wereallgeek/F4992-ESP32S3/images/compuselectorSchematics.png

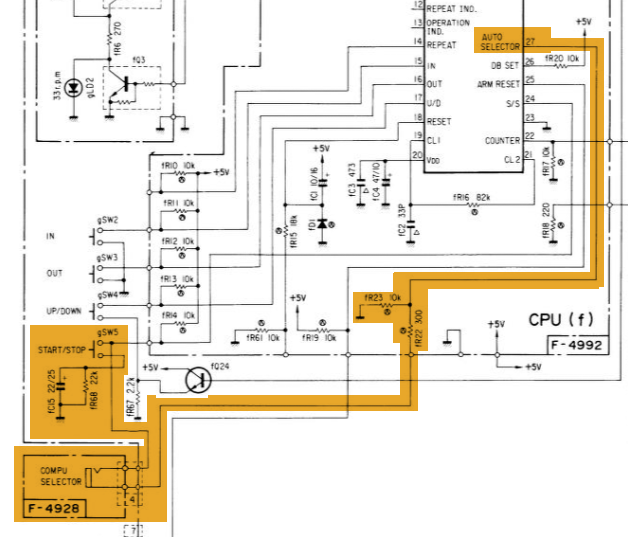
images/compuselectorSchematics.png
