wereallgeek/F4992-ESP32S3/images/zeroize.png

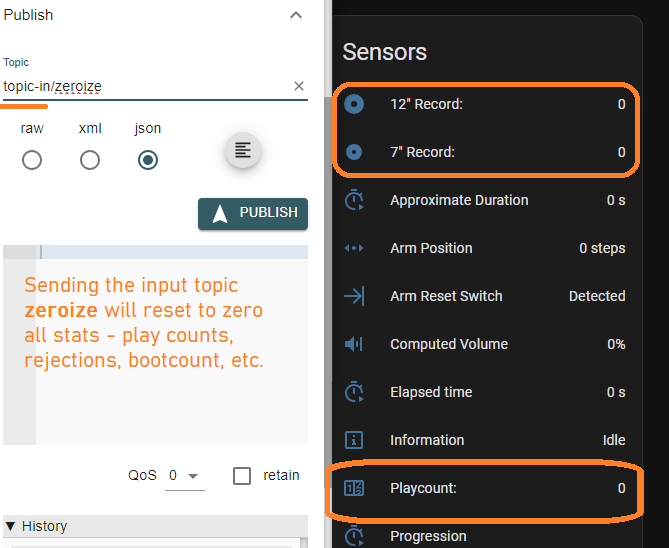
images/zeroize.png
