wereallgeek/F4992-ESP32S3/F4992-ESP32/simpleOTA.ino

//============================================================
// Simple OTA for ESP32
// 
// Opens a webserver onto which a .bin file can be uploaded
//  to the ESP for update. 
//
// Uses update.h
//
// let's build geeky things.
//                   We're all geeks
//
//============================================================
#include <WiFi.h>
#include <ESPAsyncWebServer.h>
#include <Update.h>

#define OTAPORT 4992
#define EMERPORT 80


const char* otalogo = "<img src='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' style='width:100px; margin-bottom:20px;'>";
const char* otastyle =   "<style>"
  "body{background-color:#121212;color:#ffffff;font-family:sans-serif;display:flex;flex-direction:column;justify-content:center;align-items:center;height:100vh;margin:0;}"
  ".loader{border:4px solid #333;border-top:4px solid #4caf50;border-radius:50%;width:30px;height:30px;animation:spin 1s linear infinite;margin:20px auto;}"
  "@keyframes spin{0%{transform:rotate(0deg);}100%{transform:rotate(360deg);}}"
  "</style>";

//OTA==================================================================
AsyncWebServer updateserver(OTAPORT);
AsyncWebServer emergencyserver(EMERPORT);

String updateIndex = String(otastyle) + "<form method='POST' action='/doupdate' enctype='multipart/form-data' style='text-align:center;' onsubmit='showWait()'>"
                   + String(otalogo)  + "<h5>F4992-ESP32S3 turntable controller Firmware update</h5>"
  "<p style='font-size:0.8em;color:#aaaaaa;'>current fw version = " + String(firmwareVersion()) + "</p>"
  "<div id='fcontent'>"
    "<input type='file' name='update' accept='.bin' style='margin-bottom:20px;' required>"
    "<br>"
    "<input type='submit' value='UPDATE' style='padding:10px 20px;cursor:pointer;'>"
  "</div>"
  "<div id='wait' style='display:none;'>"
    "<div class='loader'></div>"
    "<h4>Uploading firmware...</h4>"
    "<h5>Please wait, do not close this page</h5>"
  "</div>"
  "</form>"

  "<script>"
  "function showWait(){"
    "document.getElementById('fcontent').style.display='none';"
    "document.getElementById('wait').style.display='block';"
  "}"
  "</script>";

//OTA==================================================================
void setupOTA(AsyncWebServer &otaServer, const char* path) {
    otaServer.on(path, HTTP_GET, [](AsyncWebServerRequest *request){
      request->send(200, "text/html", updateIndex);
    });

    otaServer.on("/doupdate", HTTP_POST, [](AsyncWebServerRequest *request){
      bool failure = Update.hasError();
      String statusColor = failure ? "#f44336" : "#4caf50";
      String statusText = failure ? "Update Failed" : "Update Success: Rebooting...";
      
      String html = "<html><body style='font-family:sans-serif; background-color:#121212; color:white; display:flex; justify-content:center; align-items:center; height:100vh; margin:0;'>";
      html += "<div style='text-align:center;'>";
      html += "<h4 style='color:" + statusColor + ";'>" + statusText + "</h4>";
      if(!failure) html += "<h5 style='color:#888;'>Device will be back online in a few seconds</h5>";
      html += "</div></body></html>";

      AsyncWebServerResponse *response = request->beginResponse(200, "text/html", html);
      response->addHeader("Connection", "close");
      request->send(response);

      if(!failure) {
        xTimerStart(xTimerCreate("reboot", pdMS_TO_TICKS(2000), pdFALSE, (void *)0, [](TimerHandle_t xTimer){
          decrementBootcount();
          ESP.restart();
        }), 0);
      }
    }, 
    [](AsyncWebServerRequest *request, String filename, size_t index, uint8_t *data, size_t len, bool final){
      if (!index) {
        otaupdateInProgress  = true;
        setCpuFrequencyMhz(240);
        WiFi.setSleep(false);
        client.disconnect();

        Serial.printf("Update start: %s\n", filename.c_str());
        uint32_t maxSketchSpace = (ESP.getFreeSketchSpace() - 0x1000) & 0xFFFFF000;

        if (!Update.begin(maxSketchSpace, U_FLASH)) { 
          Update.printError(Serial);
        }
      }
      if (len) {
        if (Update.write(data, len) != len) {
          Update.printError(Serial);
        }
        delay(1);
      }
      if (final) {
        if (Update.end(true)) {
          Serial.printf("Update end: %u bytes\n", index + len);
        } else {
          Update.printError(Serial);
          otaupdateInProgress = false; 
        }
      }
    });
}

void simpleOTAsetup() {
  setupOTA(updateserver, "/");
}

void simpleOTAbegin() {
  updateserver.begin();
}
  
void emergencyServerSetup() {
  emergencyserver.on("/", HTTP_GET, [](AsyncWebServerRequest *request) {
    String html = "<!DOCTYPE html><html><head>" + String(otastyle) + "</head><body>";
    html += String(otalogo);
    html += "<h2>F4992-ESP32S3 turntable controller Recovery Panel</h2>";
    html += "<a href='http://" + WiFi.localIP().toString() + ":" + String(OTAPORT) + "' style='color:#4caf50;text-decoration:none;border:1px solid #4caf50;padding:10px 20px;border-radius:5px;'>Go to Firmware Update</a>";
    html += "</body></html>";
    request->send(200, "text/html", html);
  });

  emergencyserver.begin();
}

String linkToOTA() {
  if (isNetworkActive()) {
    String ipadress = getNetworkIpAddress();
    return "   <a href='http://" + ipadress + ":" + String(OTAPORT) +"' target='_blank' style='color: #00e676; text-decoration: none;'>[OTA]</a>";
  }
  return "";
}
//OTA==================================================================
