wereallgeek/F4992-ESP32S3/(commit log)

2026-04-10 corrected base name
    This will likely be added to a configuration tab in the future.
    [F4992-ESP32.ino]
2026-04-10 Added device configuration tab
    currently only got device name.
    also changed colors to remove this horrendous Alizarin red from pretty much everywhere. Carrot orange is more appropriate
2026-04-10 Restructuration
    Restructuration to avoid getting something uber confusing
    Also early debug methods for P-L45 turntable
    [Callback.ino, ESPUI.ino, F4992-ESP32.ino, simpleOTA.ino, turntableController.ino]
2026-04-12 added a console log in the web interface
    Issue is this is data intensive, trying to mutex it to avoid multiple instances from causing issues. seems to be ok. In case of problem I may roll back to just serial. but serial (trough USB) won't be useful once this thing is connected inside the turntable. hopefully I won't see more crash with the mutex.
    [Callback.ino, ESPUI.ino, F4992-ESP32.ino, WiFiMQTT.ino, turntableController.ino, webSerialLog.ino]
2026-04-12 webdebug corrections
    update less often seems to be doing good results. sometimes web server is lost on the webpage but the machine still work as seen on serial.
    also, arm movement from button request - logic seems to be working now.
    [Callback.ino, turntableController.ino, webSerialLog.ino]
2026-04-13 ongoing development
    merged UI into tonearm control ino.
    reshaped tonearm control ino
    added simulated 15/30cm sensors
    corrected names
    logic seems rather complete. will need hardware soon.
    [Callback.ino, F4992-ESP32.ino, turntableController.ino]
2026-04-13 corrected sensors
    cannot detect if not turning.
    [turntableController.ino]
2026-04-13 initial autospeed
    begins with proper DD values set
    removed timestamp from report as it was sometimes causing issues
    [turntableController.ino]
2026-04-13 correction to detect sequence
    cannot goto play at pos 0
    [turntableController.ino]
2026-04-13 fixed detect state
    now really lasts like it should.
    [turntableController.ino]
2026-04-13 soft invert
    The hardware has a physical switch to invert automatically selected speed. this change adds a software version of it.
    THIS WILL NOT MOVE THE PHYSICAL SWITCH
    They are complementary... if the switch is set to invert, soft-inverting would bring the selection back to no-invert.
    [Callback.ino, ESPUI.ino, F4992-ESP32.ino, turntableController.ino]
2026-04-14 inverted functionality of SPD INV switch
    I realized that the physical speed INV---NOR switch on my P-L45 has inversion at left so I changed the logic to make it the same on the web control panel.
    [Callback.ino, F4992-ESP32.ino]
2026-04-14 Verbosity rework
    Verbosity now live even without save. so it can be changed on-the-fly.
    changed also what non-verbosed prints. Kept mainly state change.
    Non high-verbosity also just don't have timestamps.
    [Callback.ino, ESPUI.ino, F4992-ESP32.ino, turntableController.ino]
2026-04-14 commands are no longer case-sensitive
    well, they are. commands needs to be lowercase. but no matter how you enter it, now they are converted to lowercase.
    that said, they need to be programmed as lowercase.
    [Callback.ino]
2026-04-14 comment
    Just a useless commit to make this announcement.
    I think the mutex and delay has made the ESP32 stable regardless of printing lots of text in the GUI console.
    it has not crashed a single time today and has got quite some long test runs including overnight where all was ok.
    all in all this looks promising.
    [Callback.ino]
2026-04-14 Comment
    Of course now that I said all is OK is when I get instabilities. That said, it seems the only issue is with the ESPUI web page having difficulties to connect. When this happens I get correct responses from the serial input and even sometimes updates from the web page. I assume MQTT callbacks will also be good.
    Maybe I will have to remove the online debugger.
    [Callback.ino]
2026-04-15 ESP32S3 devkit settings
    I have spent WAY too much time trying to figure out the proper settings when I changed from the ESP32C3 supermini to the ESP32S3 devkit board, so I am posting this image of the settings that worked for me.
    ALso, two things. Apparently I have been experiencing wifi issues in the last couple days causing the ESPUI to fail, I even had the IP changed. Over all this, no reboot and serial kept working.
    I have changed to the S3 devkit and have no issues whatsoever.
2026-04-16 Corrected wrong value
    Okay, okay. I call the small records 6-inch. the Sansui manual talks about 17cm records, but I erroneously said 15cm. 6inch is 15cm so there's that. anyway here's the correction. I may want to add a inch/cm switch in the interface for reporting it "correctly" - that is, up to the preferences of the user.
    [Callback.ino, F4992-ESP32.ino, turntableController.ino]
2026-04-16 Switch control
    Finally some hardware!!
    Its taken me longer than I expected but I got the switch interface working OK. I am using the Bounce2 library (to install in arduino IDE libraries) and set the debounce for all things switch to 80ms. I may want to adjust this when I connect the board to the actual turntable but that's a problem for integration, not for now.
    Currently the actual button and the web request do exactly the same. I may want to add something to "know" where the request is from, to assist with future debug.
    In any case, we now have the first pass of hardware integrated in the code. "it works at my desk!"
    [turntableController.ino]
2026-04-16 adding all arms
    This includes all switches hardware callbacks. will have to test when integrated in the turntable
2026-04-16 Starting to shape the status web page
    CSS for the win!
    it is not super versatile, but the goal is not to make something awesome. just something useful.
    we all know the webpage is mainly a debug tool. same as the serial output.
    this thing will be mainly used with physical buttons and home assistant (trough MQTT which I have not worked on yet)
    The web page needs to look good, and that's about it.
    [ESPUI.ino, F4992-ESP32.ino, turntableController.ino]
2026-04-16 small fix in the ESPUI visuals for status
    I made it so the font used for the console is not huge like it was. 10 px seems sensible. It needs to somewhat fit in the webpage as it is displayed in cellphones...
    [ESPUI.ino, F4992-ESP32.ino]
2026-04-16 more complete Status pane
    added embellishments for the Status tab - now a record (LP or Single) for size, 33/45 for speed, and unicode icons for armlift and DCM. the position and status now inline with the new stuff. I will likely rework the Configuration and WiFi sections too at some point, as this is MUCH better looking then the set of on-item-per-box ESPUI comes with
    [Callback.ino, ESPUI.ino, F4992-ESP32.ino, turntableController.ino]
2026-04-17 Internal pullups
    Before leaving the switches, I decided to enable the internal pullups.
    So, if someone does not put the resistors on the board, the switches should in theory still be functionnal. Uncertain if the electronics of the turntable will still trigger it without external pullup but its not bad.
    also, if for instance someone does not put the resistor on Sw1 because let's say he has a P-L45 that has no SW1, then the switch is not left floating.
    this seems like a good idea.
2026-04-17 Output LEDs (untested)
    I usually try to test my code carefully before I stop working on it (sometimes this means multiple commits)
    The code I am committing now is more a provision for future users as I don't have a turntable that requires this feature.
    the schematics of the P-L55 show a transistor feeds the LEDS, so the design of the daughterboard have a MOSFET level shifter, the code in this commit wants to trigger this.
    I assume it will work.
    I tested it does not fail the previous code.
    risk is minimal.
    hopefully someone will use this. (if you are this someone, enjoy!)
    Cheers!
    [turntableController.ino]
2026-04-17 Comment
    I think I figured out why sometimes it is super stable and other times I get panic reboot.
    Opening multiple web pages cause these panic. They likely refresh at the same time and ESPUI overruns the CPU into panic'd mode.
    TLDR: don't open the webpage multiple times.
    [ESPUI.ino]
2026-04-17 DCM+arm+mute hardware output
    This is the tonearm control board output.
    Note that powering the daughterboard by normal USB does not give out enough current, and the 5V rail falls flat making this untestable.
    There is a power connector on the PCB with a GND+5V that can be used to power and test the board. I have used a 5V trigger board successfully.
    note: the MUTE signal is set with some delay from asking the arm down, because the arm is not slowing very fast in real life and removing the mute too early is about as useful as not having a mute system. The delay is currently set to 1000 milliseconds, this may have to be tweaked when working on the actual system.
    Tested outputs at a nice 5V. t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
2026-04-18 Split ESPUI update
    I have separated the ESPUI updates in different sections of the update in order to not update everything together all the time; this is meant to minimize the time it takes to process the update in an effort to not starve ESPUI during update when there are multiple instances.
    I have run 4 web instances plus running commands on the serial without having the device reboot. It minimally reduces the issue.
    There are a few ESP control update that include pushing CSS to the control, and this is somewhat heavy. Multiply by several control, and multiply by multiple webpage instances, and this seems to cause issue with ESPUI.
    if the issue continue, I may have to change the web in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
    [turntableController.ino]
2026-04-18 local DNS when in WiFi mode
    Added the ability to use [devicename].local to connect to the device (using ESPmDNS)
    also moved the DNS server out of the AP mode - there is no point on wasting CPU cycles when not the DNS server on the network e.g. when we dns connect to others; this is when mDNS steps in to spread the .local anyway
    so, there's that.
2026-04-18 preparing armswitch/counter
    I am in the process of preparing the counter to be functionnal, but in the meanwhile I am still faking the arm position.
    I hope I do not require more precise than the non-delayed loop to get proper positionning of the arm as it travels from HOME to one of the records e.g. the debouncing does not cause issues. But seeing how we're running MUCH faster than the actual CPU, and that the correct drop-the-needle position is not precise to the micrometer, this may be good.
    fingers crossed.
    [turntableController.ino]
2026-04-18 arm step
    This method will not be used in normal operation but will be useful for debug.
    while I want to implement the counter, I still don't want to have to rely 100% on the turntable hardware for debugging the software. So, until I actually install the board in the turntable, I will want a way to "move the arm" (virtual representation)
    this is currently trough a += value
    the method "count one step" will be soon replaced by hardware call.
    when this is proven functional and logically sound, I will remove the debug function, but this commit goes to prepare the way for hardware-enabled methods for the same debug.
    [turntableController.ino]
2026-04-18 Hardware counter
    using hardware counter in lieu of software arm position - it is currently handled by software-enabled HIGH and LOW. have not successfully increased it by hardware yet.
    work in progress
2026-04-19 Comment
    Tested pulse counter as working.
    Again we need to be connected to a good 5V source, not just the board's USB connection.
    shorting Connector 23 (GPIO6) to HIGH gives pulse change even in idle. (as designed)
    Original design called for a R17 pulldown 10k resistor and I originally changed it to a pullup (to 3.3V) 2.2k resistor that was meant to accommodate new (ESP32) CPU but perhaps it would have been better use a voltage divider (pulldown with 5V/3.3V conversion) in order to insure proper voltage. Will try to patch the board and see if I get proper reading. Seems like the way to properly do that.
    [turntableController.ino]
2026-04-19 Infrared Record Sensors
    no debounce but otherwise works like switch. We detect in the detection phase. will have to adjust the phase lenght but otherwise the idea is this - spin record. check what IR you see. determine record size by what's blocked and what's not. Bingo.
2026-04-19 Compuselector
    Base Compuselector implementation.
    I am very confused on what this is trying to do even after looking trough the schematics and service manual so I implemented something which may be good, but may be wrong.
    so be it.
    [turntableController.ino]
2026-04-21 Correct pin assignment for SW1-2-3
    :-/
    must be one of those famous cut n' paste errors.
    [turntableController.ino]
2026-04-21 HW integration: initialization OK
    The machine moves the arm right at boot until it reaches the arm. This works nicely.
    I have not connected the input sensors yet so not much else is happening. Will make tests on input sensors before connecting, as I want to make sure what I did in the design made sense.
2026-04-21 Sensors are working
    logic was not, but sensors are.
    also changed condition to consider home "home" - now handling possible imprecisions when going home.
2026-04-21 Sensor corrections
    Like Weird Al Yankovick said in "Trigger Happy"
    "There's no feeling any greater than shoot first and ask questions later"
    yeah. here we go.
    except, I have something to correct in the hardware for sensors, as they don't go low ennough to have HIGH and LOW levels - I read 3.1-something Volts at HIGH (thanks to the pullups) but "only" 0.7V on the down. more experimentation to be done.
    It is what it is.
    [turntableController.ino]
2026-04-21 pin21 has no ADC
    ADC? Where we're going we don't need ADC.
    except, we do. even with high pullup, the phototransistors give only a 0.8 - 2.9V range which some GPIO are happy with (e.g. GPIO21) and some are not (e.g. GPIO01)
    we can analogread and set a treshold. it works. except, the GPIO21 has no ADC.
    I would like to keep both the same. I will redesign the Sensor17cm to go to GPIO03 which is free, I think that will make sense. will test it out patching the wires, first.
    [turntableController.ino]
2026-04-22 Detection works
    The sensors both work but I had to make a hardware change to get rid of the GPIO21 that has no ADC. I did not expect the phototransistor output to be too sloppy for a 3.3v ESP32. It may be possible to adjust that by hardware but using an analog reading for our own adjustment works wonder.
    It would even open up fine tuning of the threshold in the configuration.
    side note: I am having issues getting DD 33/45 output to read reliably the 33rpm value, will have to buzz the output while connected to the device.
    [turntableController.ino]
2026-04-22 Physical switch
    must have looked at the switch backward when I inverted it. Anyway, happy git, I knew exactly what to bring back.
    shite happen
    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
    [Callback.ino, ESPUI.ino]
2026-04-22 sensor still acting up
    Filtering zeroes. I suspect my connections are flaky on the debug board being that it is not installed as I want to interfere with the IOs...
    anyway sometimes it analogReads 0 on something that shouldn't - this causes false readings. filtering out.
    Oh, and adding a serial command "sensor" to see the actual readings. Will be helpful to tweak in the future.
    [Callback.ino, turntableController.ino]
2026-04-22 workin on sensors.
    the whole detection phase.
2026-04-22 Sensors working
    At least for now.
    the ADC seems to have issues; I sometimes get analogRead of 0 (technically impossible)
    Added filtering and a few methods documented online to help making the ADC less prone to errors.
    I've had 5 good readings of mixed "no disk, singles, lp"
    If I see issues again I am strongly thinking of summing up triple readings.
    But, yeah. it works.
    [F4992-ESP32.ino, WiFiMQTT.ino, turntableController.ino]
2026-04-22 more filter
    With the added filter, I have had a total of 1 wrong disc detection. It detected 30cm instead of no-disk. we're in pretty good shape.
    This commits more filtering. up to 4 reads trying to get non-zero. The zeroes still pop here and there but less.
    the "SENSOR" command will be useful for calibration. I will expose the treshold to the UI in case the turntable value drift or I didn't give enough buffer.
    [turntableController.ino]
2026-04-22 Versionning
    Manually updating version makes zero sense. "just testin this..." and no version number, then suddenly "did I upload the good version?"
    so let's use the build date which is automagically inserted in the build at, well, build time. This way the firmware never keep the same version and we know for sure what we're running.
2026-04-22 Position counter
    The position counter works. I need to alter the HW design. we're using a voltage divider. Works like a charm (almost) - the steps while going back are not as precise as the ones going in.
    Maybe it is my temporary test arm belt (read: rubber band) that isn't good. anyway, the values will need tweaking so I will have to expose them to the user
2026-04-23 PCNT
    This is the first time I use PCNT.
    so I had to learn that you can actually use a specific pin to reverse the count. instead of doing it "on the fly" which was the cause of the errors I was getting.
    good news: I have tried a series of GOEND GO30 GOEND GO30 and armdrop on the good spot still. that's actually cool to do.
    so, voltage divider is precise enough. And I was about to add chips to the mix.
    mmmm.... chips.
    [turntableController.ino]
2026-04-23 Dirty refresh
    I've been having a few reboots. Assuming ESPUI is still culprit, I am implementing on-need refresh to minimize ESPUI usage.
    [turntableController.ino, webSerialLog.ino]
2026-04-26 preparing UI setup
    So far I have been recompiling all the time for adjustment. as time goes, there is less and less bugfix and more and more adjustments.
    I noted already that the adjustments will need to be exposed to the GUI.
    This is a first step in preparation of that. Preferences are now split between the device settings (mainly wifi and name) and turntable settings (mainly the tweaks) so in the future we will be able to reset one or the other without wiping everything.
    It has begun.
    [Callback.ino, F4992-ESP32.ino, WiFiMQTT.ino, turntableController.ino]
2026-04-27 Cleaning the ESPUI
    Log output now 10 lines.
    I changed the report to fit in 10 lines and corrected the way we handle the number of lines to actually have 10 lines.
    the last line is empty. because linefeed. when we ask for 10 lines, it is 10 actual lines of information. So, well, 11 if there's a last empty line.
    [Callback.ino, turntableController.ino, webSerialLog.ino]
2026-04-28 Display settings
    It does not save yet but it displays the values.
    I also enabled a black background. Much better. Now I need to alter the color of the main font so the name of the device is better visible.
2026-04-29 update espui setup output
    Handling the webpage trough espui and all the poutine that goes around that is more complex than it seems. After strugling for some time with the fields, I got something that looks OK and behaves even if fields values are changed.
    the only remaining issue is the console that changes when entering first command. That's a problem for another day.
    Oh, and the dark theme is complete and working now!
    I am not making a light theme. if you like light theme, feel free to code it. I hate it when I can get a sunburn from all the white the screen throw at me. I won't use it so why would I bother coding it?
    [Callback.ino, ESPUI.ino, F4992-ESP32.ino, turntableController.ino]
2026-04-29 beautify urls.
    Just made that the URL is not something that seems super random, and changed the per-default MQTT topics.
    I won't be touching to MQTT until the turntable actually work, and I integrate with Home Assistant, but it is a good idea to have the defaults made with something that make sense.
    [ESPUI.ino, WiFiMQTT.ino]
2026-04-29 verbosity no longer storable settings.
    The high verbosity debug is now a live action, not a stored fact.
    this way, devices go on low verbosity at first, unless we change it.
    I may change that if I turn out needing it again.
    [Callback.ino, F4992-ESP32.ino, WiFiMQTT.ino]
2026-04-29 added help to debug console
    its not much but its there.
    type help
    Also corrected a few minor things.
    [Callback.ino, ESPUI.ino]
2026-04-29 turntable storage of values
    This will help when I get the next rev hardware as we can change values without needing a recompile. this is great.
    there's even a "default" reset. coool
    [Callback.ino, ESPUI.ino, turntableController.ino]
2026-04-29 larger fields
    on a portable device the fields were too narrow, adjusted. Also added FW version on the debug tab
    [ESPUI.ino, F4992-ESP32.ino]
2026-04-30 UP and MOVE
    Lifting the arm before moving it to avoid possible needle scratch.
    [turntableController.ino]
2026-04-30 CPU Temperature
    Added code to know CPU temperature.
    This won't be on the ESPUI except in the debug console.
    but I will expose it as an addition when I make MQTT requests, as one useless sensor.
    [Callback.ino, F4992-ESP32.ino]
2026-05-01 Led pixel
    early work on led pixel add-on
    I envision having this on the rear of the turntable behind the arm to animate while the arm is moving. A different animation depending what's going on.
    for now this is a reflection of the status as seen in the web interface.
    very experimental. may not stay.
2026-05-01 led animation state machine
    Getting the proper led animation ready on the LED driver.
2026-05-01 I can hear it
    As crazy as this sound, since I bought this turntable a few months ago, I never heard it play. I made this whole project to get to this - it plays.
    I had to correct the mute handling but now it works.
    I also used the opportunity to add mute state to the report.
    I will want to experiment with volume management, I think the setup of the P-L45 permits a PWM volume level management. Adding remote volume control is not such a bad idea if this works.
    [turntableController.ino]
2026-05-01 minimal visual UI changes
    to look better on handheld (mobile phone) devices.
2026-05-01 Dual core
    I should have done this much earlier!
    it would have been easier.
    BUT - I didn't think I'd need to.
    It seems rather stable, so I guess it works (this my first time exploiting two cores on an ESP32)
    I had random crashboot (panic'd) mainly when using the web interface.
    So, what I am doing here is separating the web interface (well, all interfaces except hardware, really) from the turntable (the hardware)
    so - Core #0 handles the ESPUI web page, the update webpage, the serial interface, the WiFi and the MQTT.
    Core#1 does the turntable.
    For that to work, I had to separate external calls to functions on the turntable from the turntable. Lots of volatile variables.
    It seems very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
    [Callback.ino, F4992-ESP32.ino, turntableController.ino, webSerialLog.ino]
2026-05-01 repeat indicator was lost
    first cleaning.
    and fix for repeat indicator.
    [turntableController.ino]
2026-05-02 comment
    I have been running the multicore firmware for several hours with exactly 0 crashboots on two units. Seems functionnal.
    [turntableController.ino]
2026-05-02 moved tem to callback.
    For some reason the ESP32 seems to always have the same digits in the temp.
    They must not be precise to the decimal. 2nd digit always zero, and always same digit for first decimal.
    screw that, round it.
2026-05-03 CPU debugging
    With dual core came large stability
    but not complete stability.
    still saw about 2 unaccounted-for reboots in the last 2 days. In order to help debugging this I will implement a few CPU-related helper methods.
    so I am moving everything cpu-wise to a new cpuInfo ino.
    [Callback.ino, F4992-ESP32.ino, cpuInfo.ino]
2026-05-03 Rework on the OTA update
    Changes priority for turntable
    changed image for board settings.
    apparently the 16Mb memory chip isn't always a 16Mb on the clone of the 16Mb devkit. go figure. 4Mb seems to work ok.
    OTA now show status before, during and after update. Much better.
    [F4992-ESP32.ino, simpleOTA.ino]
2026-05-04 Animate!
    The word animate comes from latin animatus - to give life.
    animating LEDs on the rear section of the turntable really make it more lively. still work in progress, but I like the effect.
2026-05-04 CSS reduction
    More cleaning. moved CSS where they belong - espui.
    the ones used in the code are in the UI handler now. and they are smaller.
    Crashes are caused by CPU starvation because ESPUI overuns when having multiple instances (2 or more) so I am hoping reduced CSS may help.
    I would really like to not have to remove the status page. might turn off the debug page (and place it only available on demand)
    [Callback.ino, ESPUI.ino, F4992-ESP32.ino, LedPixel.ino, turntableController.ino, turntableUiHandler.ino]
2026-05-04 follow-animation color change
    now use the state color. looks great going idle with a darker blue than play.
    Last change did reduce the CSS footprint that gets sent to ESPUI all the time. So far so good. opening and refreshing two instances to try and crash it made no crash. looks promising.
    [LedPixel.ino]
2026-05-04 Add-ons
    I think the crash were due to mishaps around the mutex - don't change the discriminator before releasing the mutex.
    The debug tab is now fully configurable. As well as some options (such as repeat & the soft speed inverter)
    Added configuration items (not all yet) for the LED driver.
    now possible to select if and how many neopixels are present.
    [Callback.ino, ESPUI.ino, LedPixel.ino, turntableController.ino, turntableUiHandler.ino, webSerialLog.ino]
2026-05-04 led chaser transitions
    looks better this way when in between two leds.
2026-05-05 breather animation
    Added breather animation.
    The LED feature seems complete. enable/disable seems stable too.
2026-05-05 no more web console
    It does not crash when webconsole is removed.
    it does sometimes when it is present.
    sometimes enabling the web console would put the unit in infinite reboot requiring external reflash.
    so I am removing the web console completely.
    I was happy to use it during development, but the code has matured enough that it is not as needed as it was. I added a stats tab. will also add helper functions to assist with calibration. but the only command entry and output will be with serial (and I doubt we'll use it once the device is installed in the turntable so I may remove some of it too)
    it is what it is.
    [Callback.ino, ESPUI.ino, F4992-ESP32.ino, WiFiMQTT.ino, cpuInfo.ino, turntableController.ino, turntableStats.ino, turntableUiHandler.ino]
2026-05-05 reshaped the stats report
    No web gui to limit number of lines, reshaped the report.
    Also makes it better for the ESPUI Stats tab.
    added arm helper buttons in config. now that there's no console to to the commands, had to make them available to help with adjustments.
2026-05-05 Emergency ESPUI bypass
    Added a way to bypass the ESPUI webserver (which is what causes issues at some point, requiring to flash another version)
    if holding the MOVE OUT button, will load a basic port 80 server to push towards the OTA server and reflash instead of the ESPUI iunterface.
    at this point the turntable still works.
    I will likely do similar with MOVE IN button to bypass the turntable task, in order to ensure it is possible to reflash without opening the turntable no matter what failed.
    [F4992-ESP32.ino, simpleOTA.ino, turntableController.ino]
2026-05-06 no more stats tab
    I guess it makes sense that adding lots of controls in ESPUI gives similar effect than the large text of the debug console.
    so it is gone. And so are the regular panic crash due to the webstack
    These stats will be visible trough MQTT, so there's that.
    [ESPUI.ino, turntableController.ino]
2026-05-06 Bypass turntable
    In case of TT issue in code update, we can now bypass by holding switch2 (move in) at power-up
    So:
    Switch3 (move out) bypass espui
    Switch2 (move in) bypass turntable
    Note: Switch4 is HW problematic as it won't be recognized by the CPU (by design) until the platter turns.
    note2: on my unit, the start/stop button is somewhat less certain of a being pressed, because it is just old and used.
    I will likely bypass MQTT with the turntable - if the problem is within ESPUI we can bypass it, but if it is on anything else, running ESPUI can permit storing values for the next boot before having to install another firmware.
    in all cases, the firmware update port is available.
    This m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
    [F4992-ESP32.ino, turntableController.ino]
2026-05-06 First MQTT test
    Send discovery for auto HA discovery of the device.
    this will need lots of rework. but I want to store this iteration on GIT for reference when it fails later.
    [F4992-ESP32.ino, WiFiMQTT.ino]
2026-05-06 publishing stats to mqtt
    all stats publish on mqtt. the web page is now oldschool lol
    the turntable input and output are not handled yet. no call back implemented yet. but the outputs all work ok.
    had to change the "none" crash cause as HA didn't understand it, and showed Unknown. reformed some of it.
    [Tools.ino, WiFiMQTT.ino, cpuInfo.ino, turntableStats.ino]
2026-05-06 removing crash reason from espui
    now that I have a reliable way to know.
    [ESPUI.ino]
2026-05-07 output controls mqtt
    early callback and most of turntable controls. Tested on hardwareless device. Still need to upload to actual turntable.
    but that's a problem for tomorrow.
    [Callback.ino, WiFiMQTT.ino]
2026-05-07 fixes
    Sensor cannot be config. HA rejects it.
    removerd the permanent WIFI and MQTT count. now only current session.
    Crash and reset reasons back to what it was.
    [Callback.ino, WiFiMQTT.ino, cpuInfo.ino]
2026-05-07 revamp OTA
    MQTT was failing the update. Now wifi and main loop is OFF during OTA update.
    [F4992-ESP32.ino, WiFiMQTT.ino, simpleOTA.ino]
2026-05-07 Detection phase changed
    Simple change but now we wait for detection before moving the arm.
    After having several days of flawless detection, I am getting false positives. When it wrongly detect the record, it drops the needle on the mal That's bad (very bad) for the needle.
    I prefer false negative and delay than buying a new needle.
    So, a longer detection phase.
    Problem, the arm would "stutter" if detection is longer than it takes to reach the 12inch start location (move, stop, move again) which is annoying.
    so, longer detection period. Wait for record to be detected. Then move the arm.
    also, it makes that the arm won't move at all when no record is there.
    I like it.
    [turntableController.ino, turntableUiHandler.ino]
2026-05-07 added NOGO state
    Now that the arm doesn't move if there's no record, there's no feedback. If led pixels are installed, this NOGO state will display rejection; the interface (both ESPUI and MQTT) will pass trough one red rejection phase.
    [LedPixel.ino, turntableController.ino, turntableUiHandler.ino]
2026-05-07 Detect NOGO directly
    We cannot know when we haven't seen something yet, but we can know for sure when we have certainly seen it. No point on making a full cycle if both IR sensor sensed the IR beam. Cut detection phase, and throw the NOGO warning.
    Also, changed duration. If NOGO and relaunch directly, wouldn't even do something if IR phase too long (longer than the sequence?)
    the detection phase cannot be shorter than 3000 if the sensor are just passed the LED and the platter needs to gain speed. its all a matter of how long before the IR sensor can actually detect the beam.
    3 sec detect duration seems good. with the auto reject, we may reduce the IR phase duration quite some time.
    [turntableController.ino, turntableUiHandler.ino]
2026-05-08 Oopsie!
    If detection happens while the arm is at home, the software was also resetting the record back to NODISC.
    Chasing this regression, I cleaned several things.
    Oh, and I had forgotten to add the arm position to MQTT - this is somewhat the most interesting thing to watch. (not really but its useful anyway)
    so yeah, here's the fix.
    [WiFiMQTT.ino, turntableController.ino, turntableUiHandler.ino]
2026-05-08 ZZzzzzz
    Put WIFI (core0) in low energy mode when IDLE, and reduce core 1 refresh rate
    the goal is to reduce power usage if possible, and so reduce heat. On early tests, temp core temp dropped instantly 5 degrees. Testing shows no adverse effect (maybe long-term wifi?) - the lower specs are ONLY when IDLE.
2026-05-08 Also reduce frequency in IDLE
    lower freq = less power = less heat.
2026-05-08 proper degrees
    unsure this passes great in GIT but mqtt and arduino sure are happy with it on my side.
2026-05-09 cosmetic changes for ESPUI
    initial state at boot up wasn't great. Also singles was too big
    [Callback.ino, ESPUI.ino, WiFiMQTT.ino, turntableController.ino, turntableUiHandler.ino]
2026-05-09 VOLUME CONTROL
    As I suspected, the transistor circuitry to mute the audio can be stimulated as a volume limiter.
    Which means if we PWM the value instead of all on or all off, we can limit the volume. There are limitations, but it works.
2026-05-10 no use empty epoch
    to avoid using the empty epoch
    [WiFiMQTT.ino]
2026-05-11 Altering time
    Well, the place we are on the record (elapsed time)
    REW, FFWD, set to %of record. buttons for it. tried to put it in the mqtt_media_player and it seems the implementation has the button visibility reverted (at least for mine) so I am just using the buttons. the feature works if the buttons are available and there's two callbacks to trap it.
    [Callback.ino, F4992-ESP32.ino, WiFiMQTT.ino, turntableController.ino, turntableUiHandler.ino]
2026-05-11 Detailed status for mediaplayer
    Also reporting this as supplemental entities in mqtt.
    note: the elapsed time is wrong but gives an OK approximation of position. Might work on better position VS time computation in the future.
    [Tools.ino, WiFiMQTT.ino, turntableUiHandler.ino]
2026-05-12 Added F/W tab
    Added a F/W tab to properly locate F/W version and OTA link.
    Changed the OTA link text.
    Changed the tab names and order
    changed a few label text for better vision on smaller device (espui/cellphone wasn't looking good)
2026-05-13 Led cross-fade
    This commit wants to resolve the issue of in-between LEDs and their illumination by adding cross-fading.
    I was also hoping to resolve a visual glitch where in idle after raising the arm physical left-right button movement of the arm has a green LED left of the arm that flash in an undetermined fashion - it was there prior to the fix, the crossfade does not resolve that.
    [LedPixel.ino]
2026-05-13 Time-based FFWD REW
    The initial implementation of moving the arm in MQTT was done with the slider which sent percent. So the FFWD and REW was simply a percentage+1.
    A 1% position change for a LP can be about 10 seconds.
    changed that for time-based displacement. FFWD and REW now adds a few seconds. May tweak how many, but it makes for a more reasonable movement.
2026-05-13 Don't drop the needle without looking first if there's a record
    This commin prevents user from moving the arm over the platter from HOME using MQTT.
    It doesn't let it on web interface, it doesn't let it on the physical interface; it should not on the web interface either.
    the reason behind this is that the arm should not be on top of the platter when there's no record - or on the unused part of the platter on small records. Making the arm move without discovery is bad.
    wouldn't want to automate a needle drop on the mat.
    it was somewhat fun to test the arm movement freely before rotation, but once it is not a large record on the platter, the danger is real.
    Safety first.
    [Callback.ino]
2026-05-15 better volume control
    now the 0-100% range for volume control has exposed PWM values for correct adjustments. the extremes (0 and 100) are still forced at 0 and 100 - in most case 100 is good. But the useful range of the PWM in this case is not 0-255.
    The electronics to control the mute system has only a middle-value range that works, so we need to map the 0-100 properly to have something useful for a volume range, otherwise the slider does nothing half the time.
    [Callback.ino, ESPUI.ino, turntableVolumeFader.ino]
2026-05-15 Better MQTT update
    don't leave a topic unchanged for too long.
    I was somewhat hoping that HA would reset unused number slider with that but while the topic does gets sent tou, HA ignores it because it is unchanged. Tried to force update, no change. might explore force update again later.
    [WiFiMQTT.ino]
2026-05-15 Idle timeout
    If IDLE over the revolving platter for too long - like when you pause the playback and forger the turntable isn't off - will get bored and say "screw you guys, I'm going home"
    [ESPUI.ino, F4992-ESP32.ino, turntableController.ino, turntableUiHandler.ino]
2026-05-16 Realtime
    The play timer is now an actual elapsed time with pause and FFWD computation.
    that results in a much more fluid time display than seconds computed from step counter conversion.
    the time displacement when moving the arm may have some inconsistencies but is a good approximation.
    the total record lenght is still a complete approximation.
2026-05-16 Update turntableController.ino
    missing code from previous commit
    [turntableController.ino]
2026-05-16 HA number with decimals
    Also fixed bad cut n paste from previous set of commits.
    now sending 3 digits to and from HA for number slider for the arm. I hoped to erradicate stutter but there still is. I think the issue is not in ESP32 but in HA and how it handles the incoming number.
    it is still great, and I have the very fluid elapsed time to show underneat.
    [WiFiMQTT.ino, turntableUiHandler.ino]
2026-05-17 ESPUI Overhaul
    The return of the web debug console.
    After removing the console, there was still random reboots. But now that ESPUI has been managed properly these are gone.
    Time to test the web console again. It works without causing too much instability.
    I have openned 5 web browser before seing one random panic crash, and it didn't repeat. I blame the size of the webpage.
    So, to reduce the page (and to declutter) I added options for Wifi (defaults ON)
    also H/W tab (once configured we may never have to go back to it)
    Some features are "advanced" such as LED or Volume, so these are also optionned out.
    the resulting set of tabs is much less cluttersome.
    and extended usage of the page led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
    [Callback.ino, ESPUI.ino, F4992-ESP32.ino, WiFiMQTT.ino, turntableController.ino, turntableStats.ino, turntableUiHandler.ino]
2026-05-17 missing file
    For some reason the webseriallog file didn't commit.
    here it is
    [WiFiMQTT.ino, webSerialLog.ino]
2026-05-18 added link to PCB Shared project
    PCBWay sponsored rev1 and rev2 PCBs for this project, thanks a lot.
    I truly believe the way they handle electronics community to be a great assets - the shared projects section is a great asset for anyone to find PCBs for their geeky projects. I've built lots of stuff with PCBs from the shared projects, and the hardware for the F4992-ESP32S3 is now available there.
    https://www.pcbway.com/project/shareproject/F4992_ESP32S3_CPU_board_replacement_586c1eb8.html
2026-05-19 Serial commands
    now that we have serial commands back to the web interface, zeroing the stats is interesting.
    Also made a standalone "reset boot count" as this is the one that trigers me to reset... on the dev board I had over 900 boot count, and 0 play count...
    [Callback.ino, turntableStats.ino]
2026-05-19 Better times
    Hook to current arm position not the refresh-enabled variant.
2026-05-19 Smart Feature - Record-skipping bypass
    Here is an actual smart feature for a turntable. detect a scratched record that loops, and skip it.
    When you play, the tray advance, wait for the arm, advance, wait for the arm, advance...
    If it never advance, then we're stuck in a loop.
    Skip this loop.
    The duration of the scratch loop sensor needs to be long because of the tray/arm dynamic. I have set it to 15000 (miliseconds) as lower skips non-scratches.
    The skip (in steps) is currently 5. I tought I'd be OK with 2, as I think you advance to the next groove with two steps, but it was doing it 3 times at that value. 5 seems good.
    The skip feature adds a new stat.
    Also added an MQTT output for th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
    [Callback.ino, ESPUI.ino, F4992-ESP32.ino, WiFiMQTT.ino, simpleOTA.ino, turntableController.ino, turntableStats.ino, turntableUiHandler.ino]
